PedroHiago378/humanoide-12dof/docs/artigo/fig_arquitetura.png

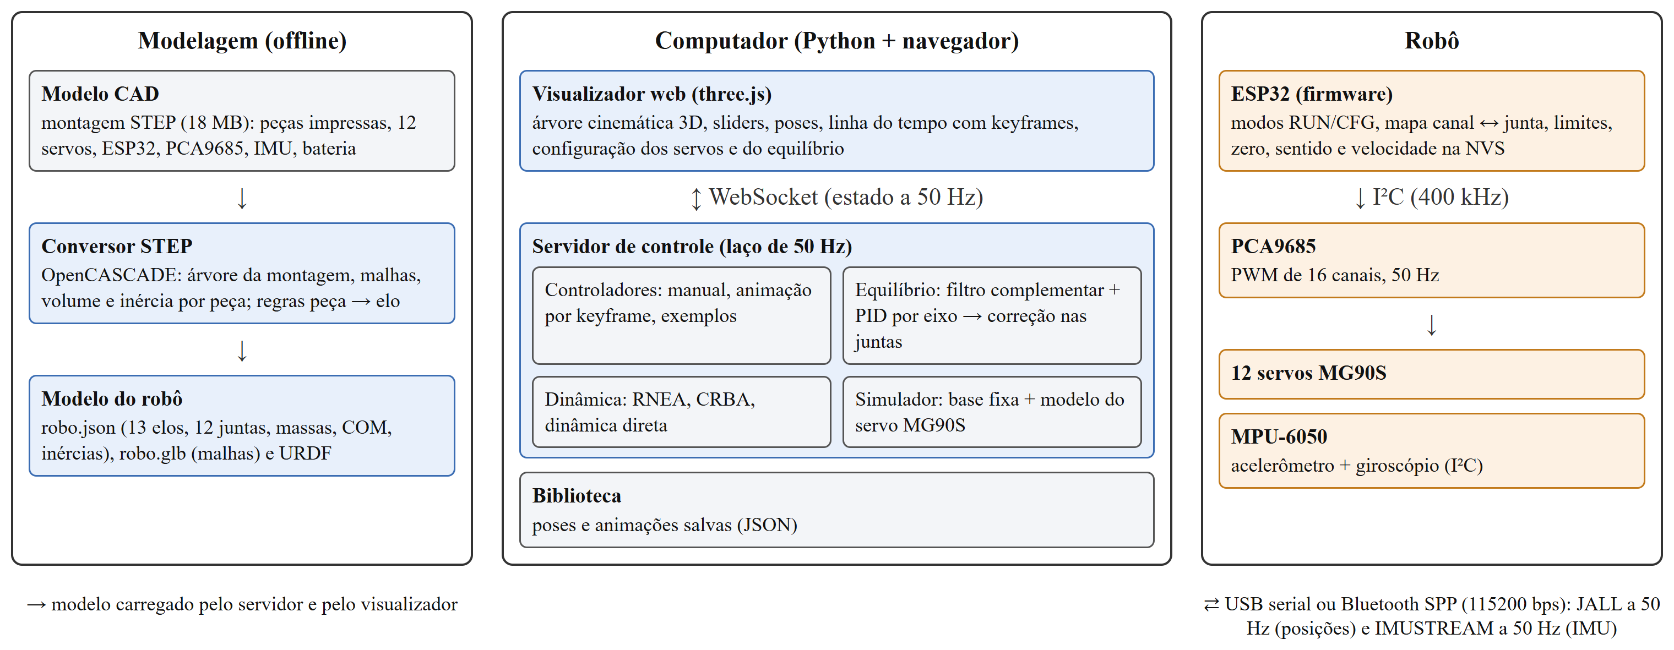
docs/artigo/fig_arquitetura.png
