PedroHiago378/humanoide-12dof/docs/artigo/fig_config_servos_crop.png

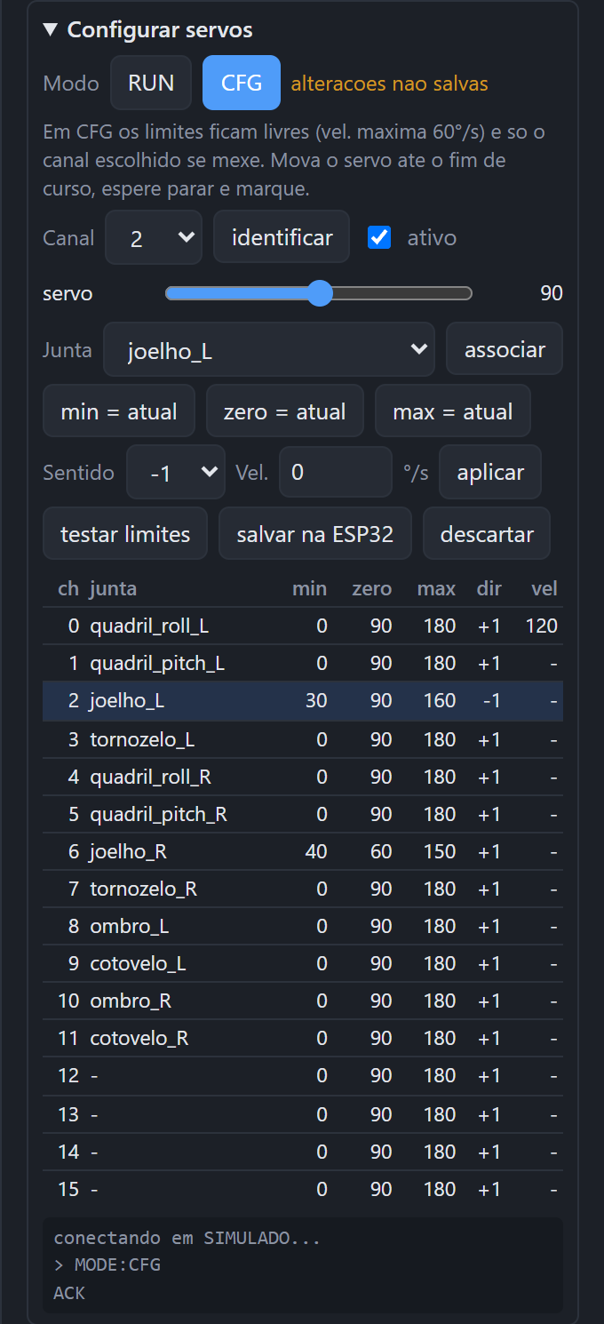
docs/artigo/fig_config_servos_crop.png
