PedroHiago378/humanoide-12dof/docs/artigo/fig_equilibrio.png

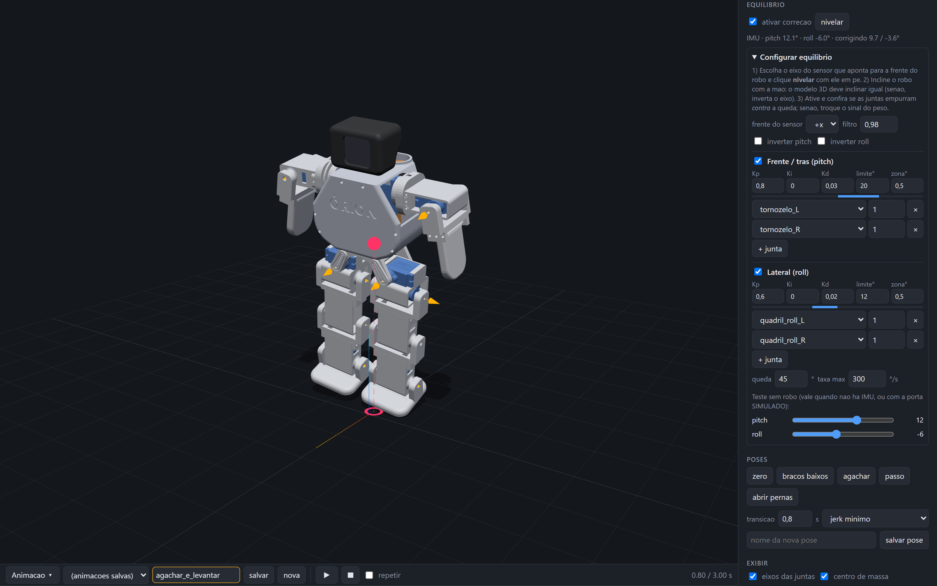
docs/artigo/fig_equilibrio.png
