PedroHiago378/humanoide-12dof/docs/artigo/fig_interpolacao.png

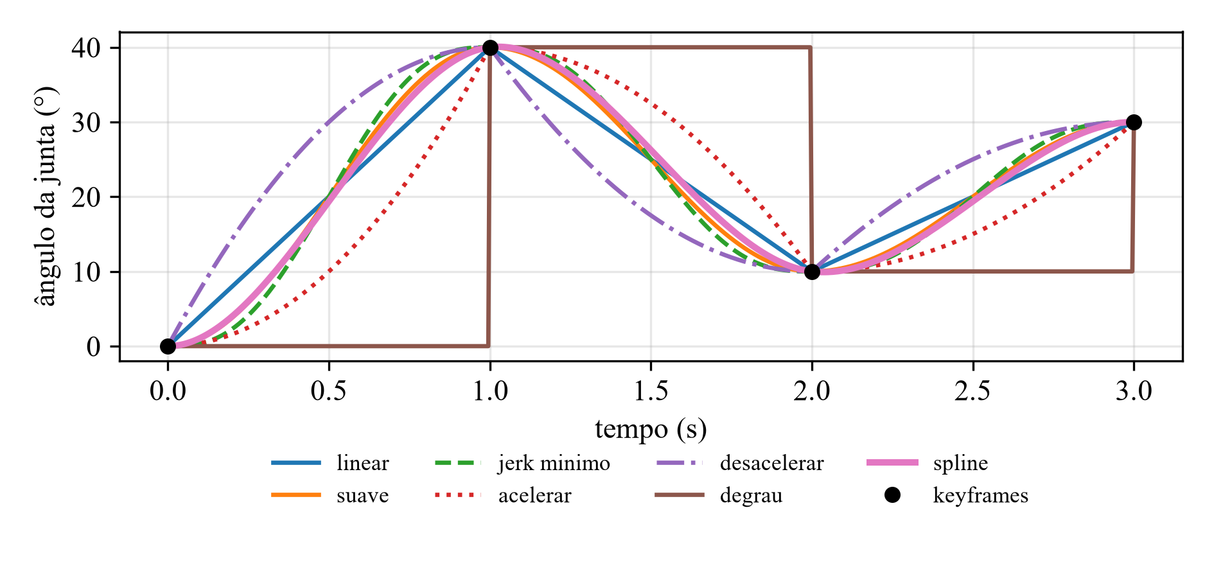
docs/artigo/fig_interpolacao.png
