PedroHiago378/humanoide-12dof/docs/artigo/fig_visao_geral.png

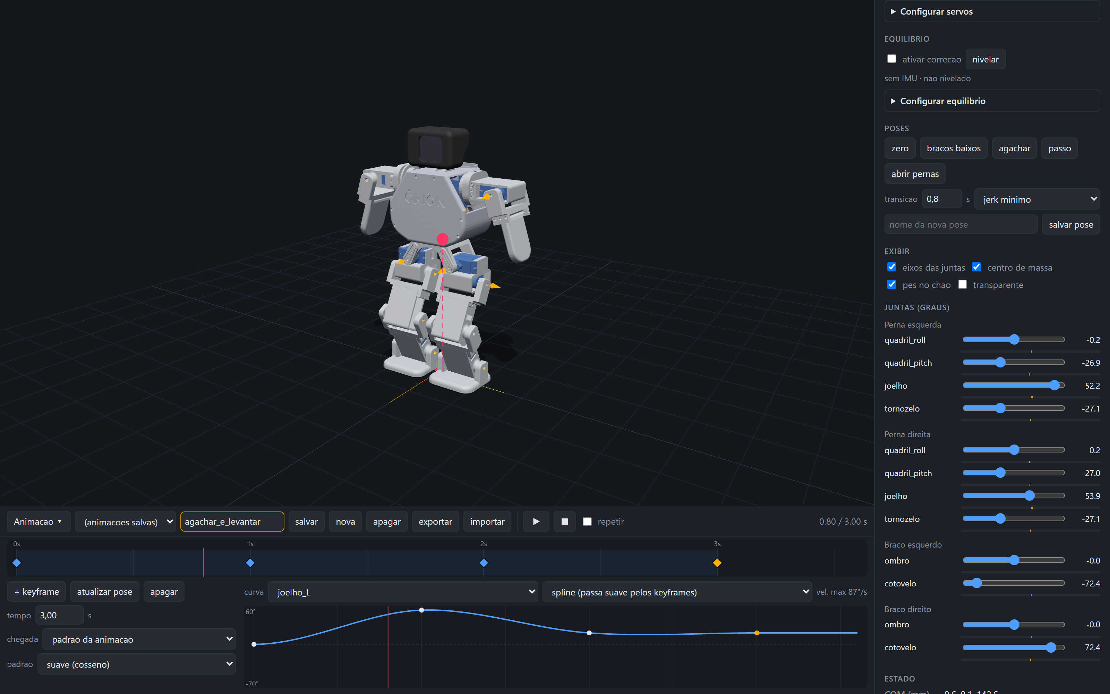
docs/artigo/fig_visao_geral.png
