PedroHiago378/humanoide-12dof/modelo/mujoco/colisao/pe_L.stl

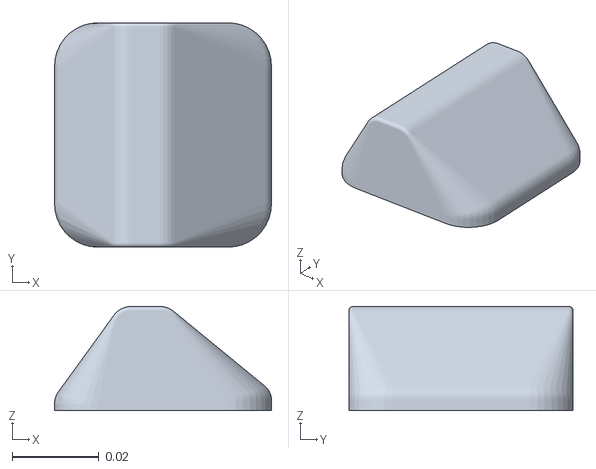
[picture p7: CAD file, 2026-11-02]
modelo/mujoco/colisao/pe_L.stl
0.05 x 0.0517 x 0.024
