PedroHiago378/humanoide-12dof/modelo/mujoco/visual/torso_0.stl

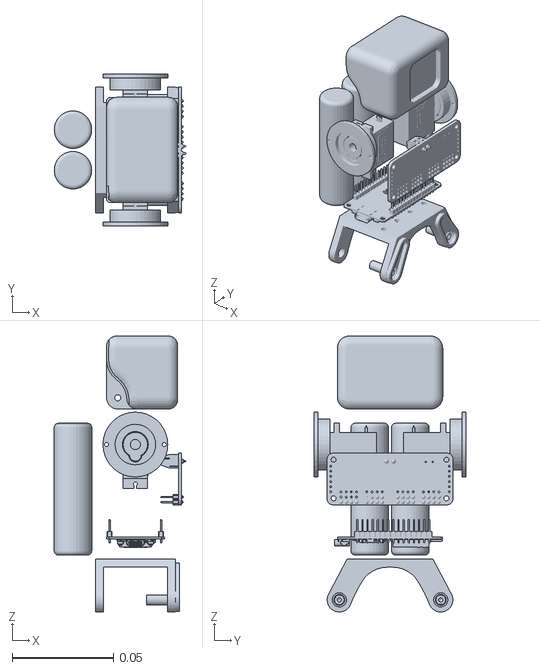
[picture p8: CAD file, 2026-11-02]
modelo/mujoco/visual/torso_0.stl
0.0649 x 0.075 x 0.136
