PedroHiago378/humanoide-12dof/modelo/mujoco/colisao/coxa_L.stl

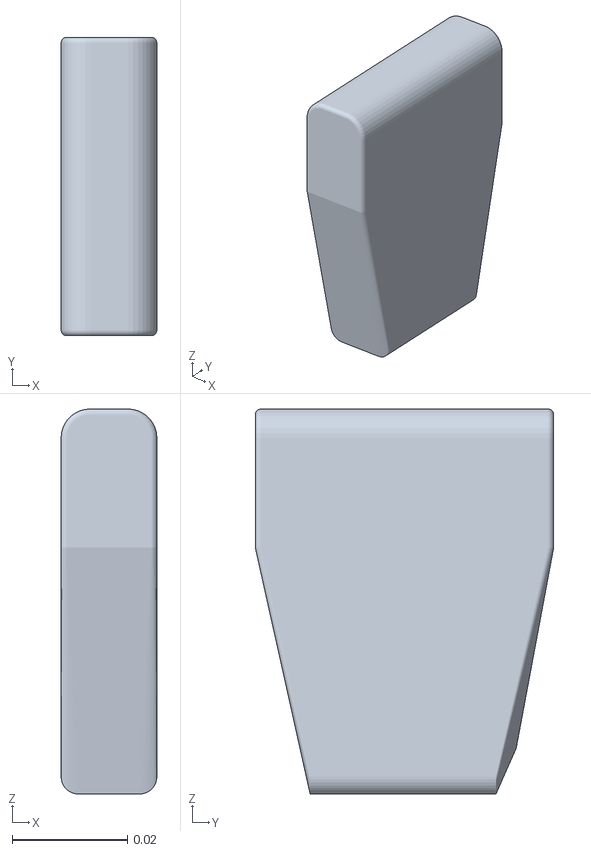
[picture p9: CAD file, 2026-11-02]
modelo/mujoco/colisao/coxa_L.stl
0.0166 x 0.0517 x 0.0667
