PedroHiago378/humanoide-12dof/modelo/mujoco/visual/coxa_R_0.stl

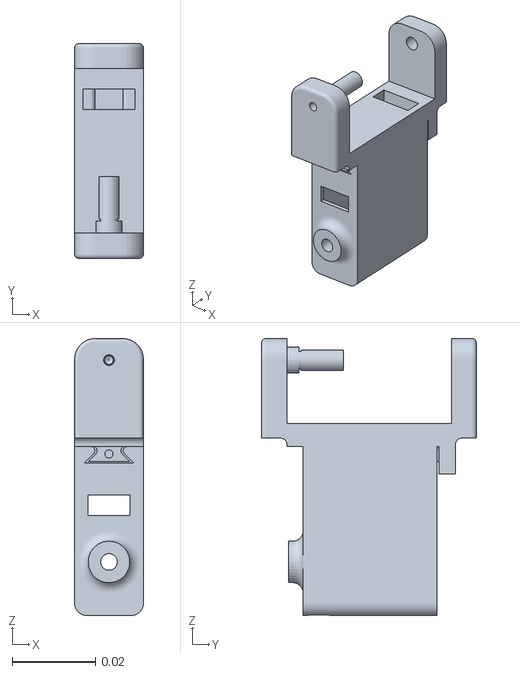
[picture p10: CAD file, 2026-11-02]
modelo/mujoco/visual/coxa_R_0.stl
0.0166 x 0.0517 x 0.0667
