PedroHiago378/humanoide-12dof/modelo/mujoco/colisao/braco_L.stl

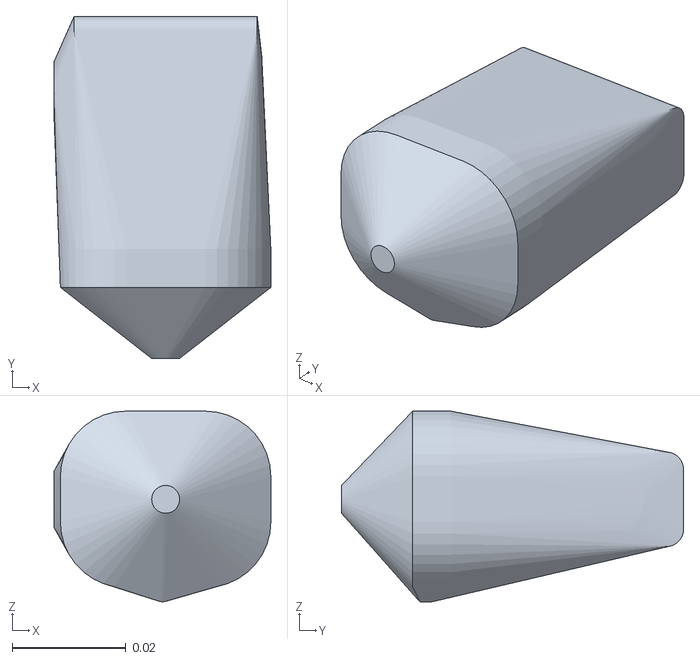
[picture p11: CAD file, 2026-11-02]
modelo/mujoco/colisao/braco_L.stl
0.0381 x 0.0601 x 0.0335
