PedroHiago378/humanoide-12dof/modelo/mujoco/colisao/antebraco_L.stl

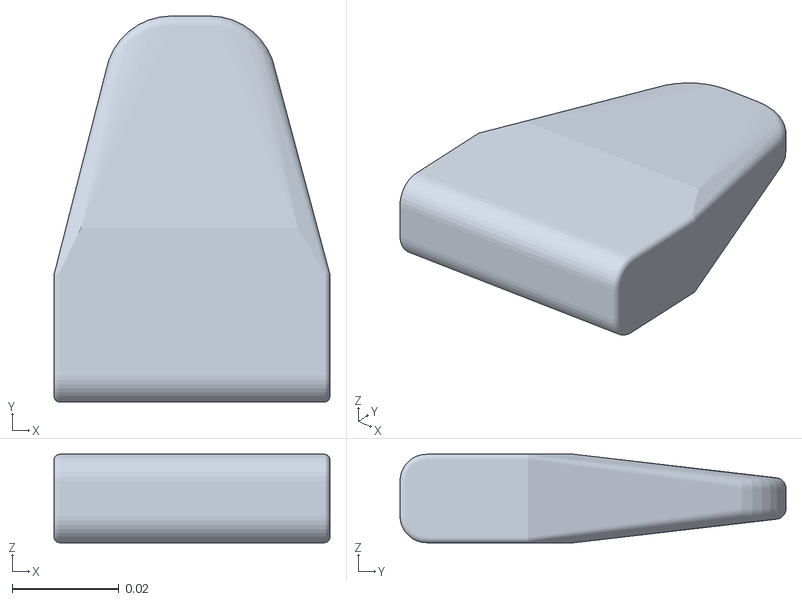
[picture p12: CAD file, 2026-11-02]
modelo/mujoco/colisao/antebraco_L.stl
0.0517 x 0.0724 x 0.0166
