PedroHiago378/humanoide-12dof/modelo/mujoco/visual/pe_R_0.stl

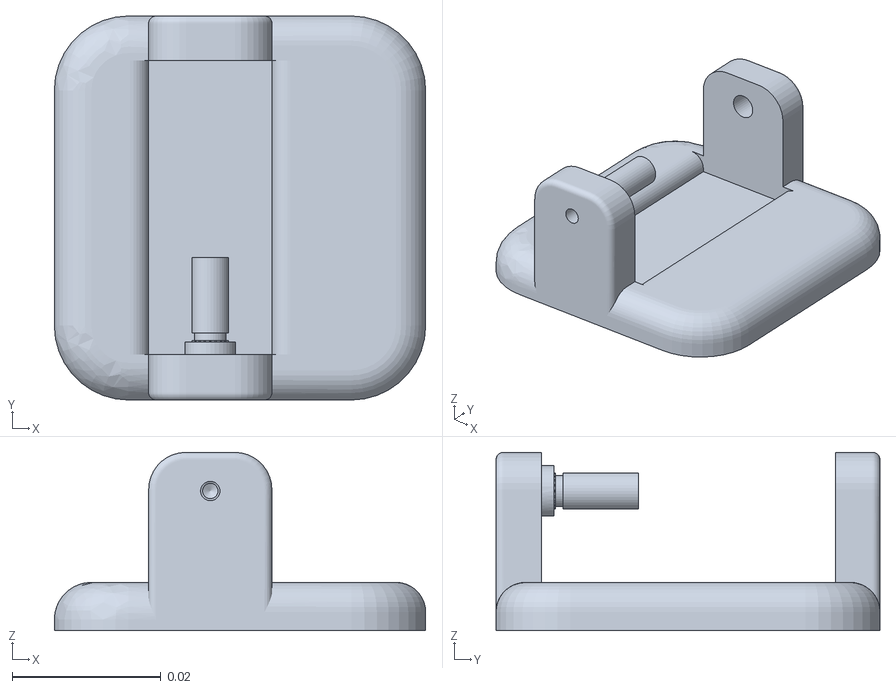
[picture p13: CAD file, 2026-11-02]
modelo/mujoco/visual/pe_R_0.stl
0.05 x 0.0517 x 0.024
