PedroHiago378/humanoide-12dof/modelo/mujoco/visual/antebraco_L_0.stl

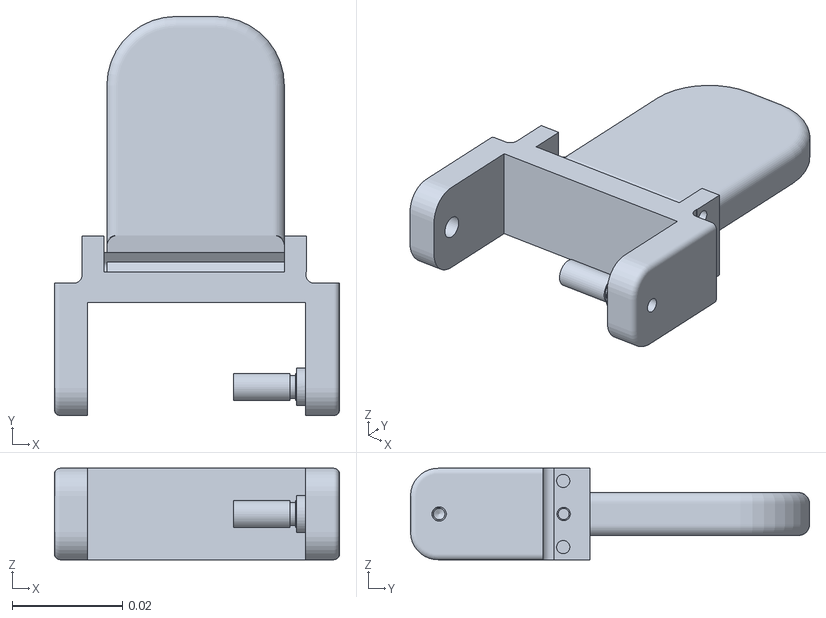
[picture p16: CAD file, 2026-11-02]
modelo/mujoco/visual/antebraco_L_0.stl
0.0517 x 0.0724 x 0.0166
