PedroHiago378/humanoide-12dof/modelo/mujoco/colisao/quadril_L.stl

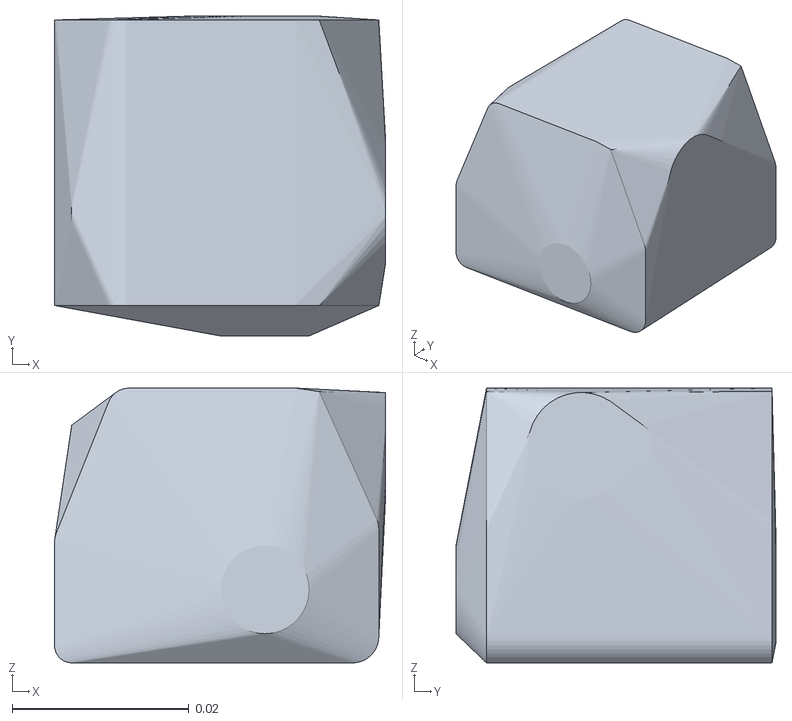
[picture p17: CAD file, 2026-11-02]
modelo/mujoco/colisao/quadril_L.stl
0.0374 x 0.0362 x 0.0311
