PedroHiago378/humanoide-12dof/modelo/mujoco/visual/torso_1.stl

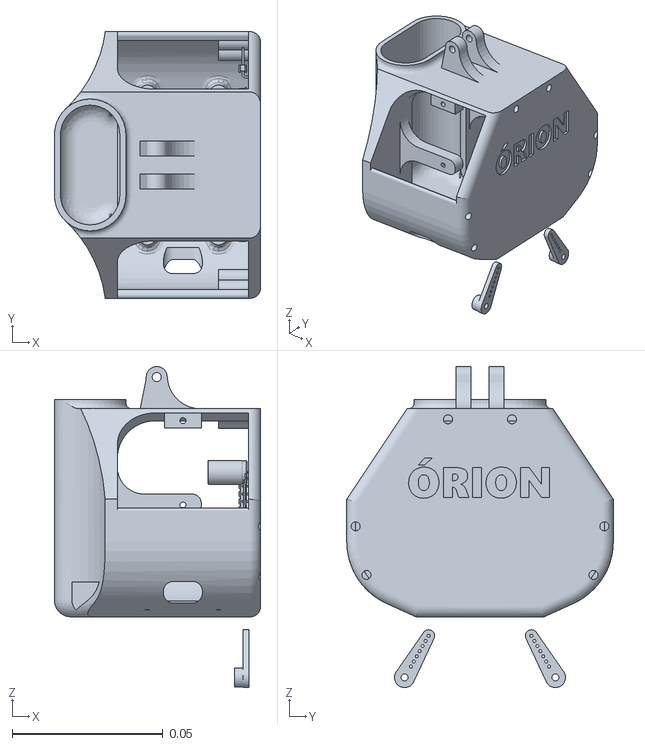
[picture p18: CAD file, 2026-11-02]
modelo/mujoco/visual/torso_1.stl
0.0683 x 0.0884 x 0.106
