PedroHiago378/humanoide-12dof/modelo/mujoco/visual/braco_R_0.stl

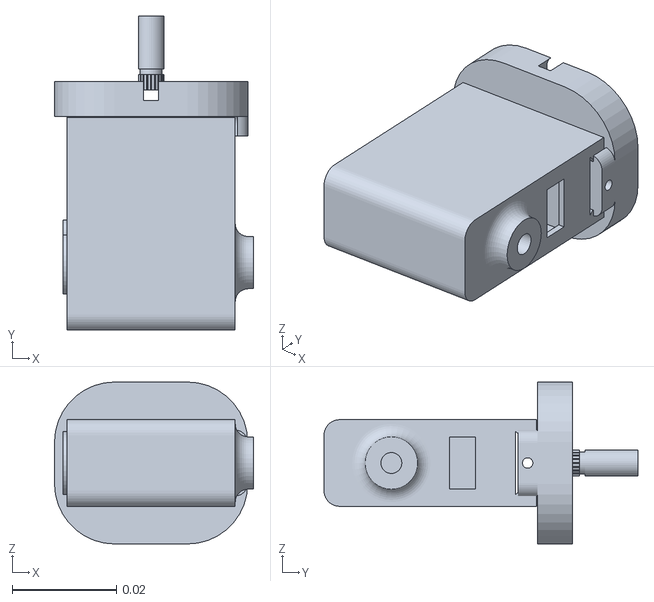
[picture p19: CAD file, 2026-11-02]
modelo/mujoco/visual/braco_R_0.stl
0.0381 x 0.0601 x 0.031
