PedroHiago378/humanoide-12dof/modelo/mujoco/colisao/torso.stl

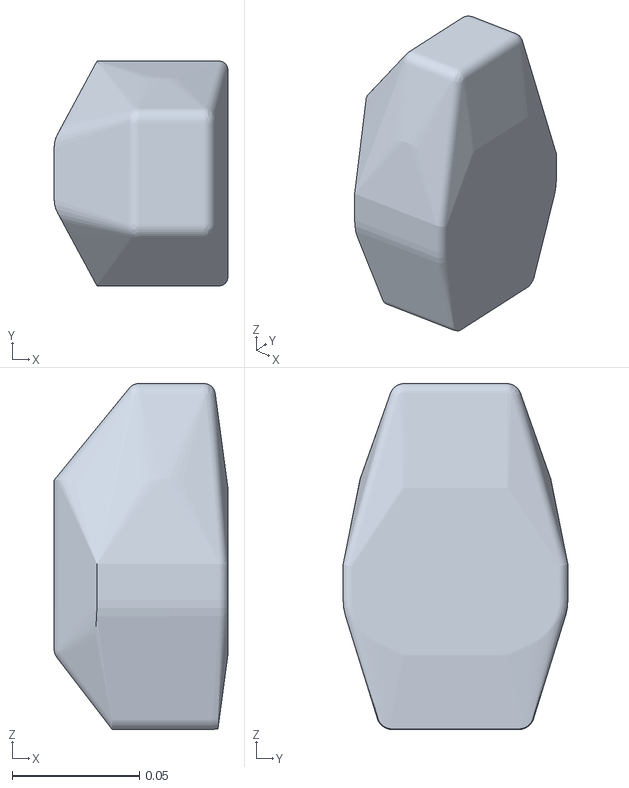
[picture p20: CAD file, 2026-11-02]
modelo/mujoco/colisao/torso.stl
0.0683 x 0.0884 x 0.136
