PedroHiago378/humanoide-12dof/modelo/mujoco/visual/quadril_L_0.stl

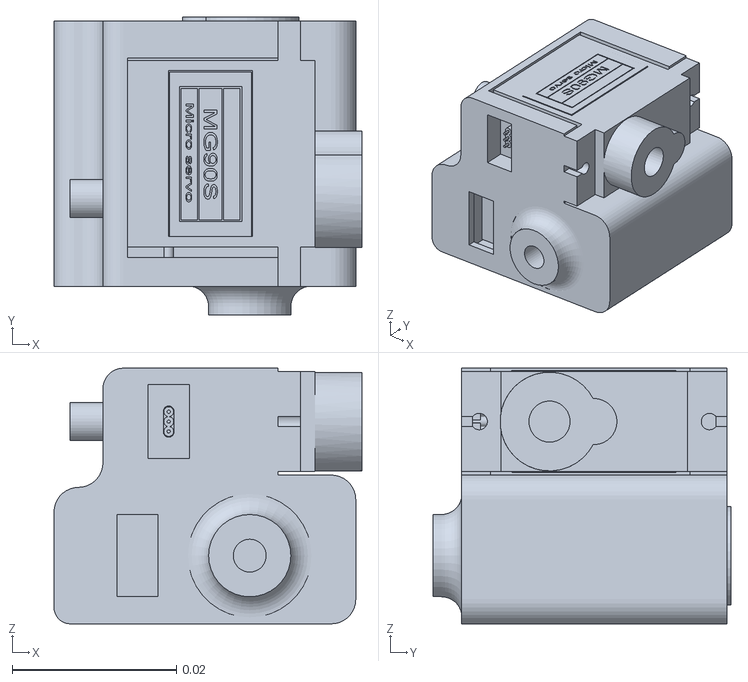
[picture p21: CAD file, 2026-11-02]
modelo/mujoco/visual/quadril_L_0.stl
0.0374 x 0.0362 x 0.0311
