PedroHiago378/humanoide-12dof/modelo/mujoco/visual/canela_L_0.stl

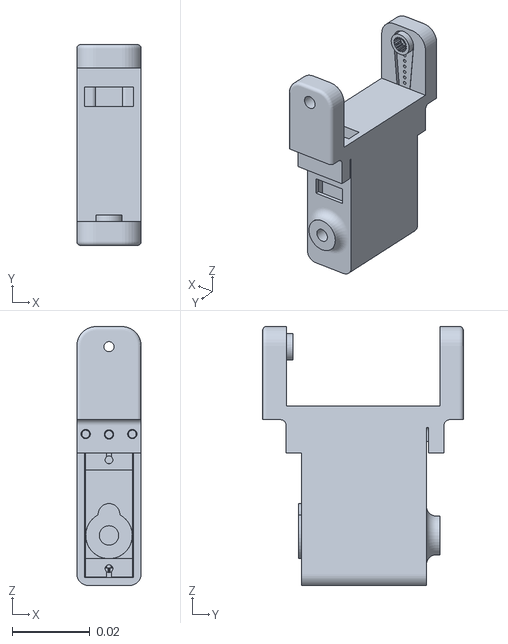
[picture p22: CAD file, 2026-10-30]
modelo/mujoco/visual/canela_L_0.stl
0.0166 x 0.0517 x 0.0667
