PedroHiago378/humanoide-12dof/(list of files, cad)

Other CAD files:
modelo/mujoco/visual/coxa_L_0.stl
modelo/mujoco/colisao/canela_R.stl
modelo/mujoco/colisao/canela_L.stl
modelo/mujoco/colisao/antebraco_R.stl
modelo/mujoco/visual/antebraco_R_0.stl
modelo/mujoco/visual/pe_L_0.stl
modelo/mujoco/colisao/pe_R.stl
modelo/mujoco/colisao/coxa_R.stl
modelo/mujoco/colisao/quadril_R.stl
modelo/mujoco/visual/quadril_R_0.stl
modelo/mujoco/visual/canela_R_0.stl
modelo/meshes/antebraco_L.stl
modelo/meshes/antebraco_R.stl
modelo/meshes/braco_L.stl
modelo/meshes/braco_R.stl
modelo/meshes/coxa_L.stl
modelo/meshes/coxa_R.stl
modelo/meshes/pe_L.stl
modelo/meshes/pe_R.stl
modelo/meshes/quadril_L.stl
modelo/meshes/torso.stl
