PedroHiago378/humanoide-12dof/modelo/robo.urdf

<?xml version="1.0"?>
<robot name="humanoide_12dof">
  <link name="torso">
    <inertial><origin xyz="-0.01809 0.00027 0.06021"/><mass value="0.23706"/>
      <inertia ixx="0.000261755" ixy="-8.658e-07" ixz="-1.9638e-05" iyy="0.000278881" iyz="-1.5759e-06" izz="0.000175768"/></inertial>
    <visual><geometry><mesh filename="meshes/torso.stl"/></geometry></visual>
    <collision><geometry><mesh filename="meshes/torso.stl"/></geometry></collision>
  </link>
  <link name="antebraco_L">
    <inertial><origin xyz="-0.00668 0.02866 -3e-05"/><mass value="0.01676"/>
      <inertia ixx="5.9565e-06" ixy="1.676e-07" ixz="-0" iyy="3.5088e-06" iyz="0" izz="9.0447e-06"/></inertial>
    <visual><geometry><mesh filename="meshes/antebraco_L.stl"/></geometry></visual>
    <collision><geometry><mesh filename="meshes/antebraco_L.stl"/></geometry></collision>
  </link>
  <link name="antebraco_R">
    <inertial><origin xyz="0.00581 -0.02869 -3e-05"/><mass value="0.01676"/>
      <inertia ixx="5.9565e-06" ixy="-4.82e-08" ixz="0" iyy="3.5133e-06" iyz="0" izz="9.0492e-06"/></inertial>
    <visual><geometry><mesh filename="meshes/antebraco_R.stl"/></geometry></visual>
    <collision><geometry><mesh filename="meshes/antebraco_R.stl"/></geometry></collision>
  </link>
  <link name="braco_L">
    <inertial><origin xyz="-5e-05 0.03495 -5e-05"/><mass value="0.02715"/>
      <inertia ixx="6.0057e-06" ixy="-1.157e-07" ixz="-3e-10" iyy="2.8934e-06" iyz="-1.22e-08" izz="7.2874e-06"/></inertial>
    <visual><geometry><mesh filename="meshes/braco_L.stl"/></geometry></visual>
    <collision><geometry><mesh filename="meshes/braco_L.stl"/></geometry></collision>
  </link>
  <link name="braco_R">
    <inertial><origin xyz="-6e-05 -0.03516 -3e-05"/><mass value="0.0269"/>
      <inertia ixx="5.8859e-06" ixy="-1.129e-07" ixz="-0" iyy="2.8766e-06" iyz="-0" izz="7.1831e-06"/></inertial>
    <visual><geometry><mesh filename="meshes/braco_R.stl"/></geometry></visual>
    <collision><geometry><mesh filename="meshes/braco_R.stl"/></geometry></collision>
  </link>
  <link name="canela_L">
    <inertial><origin xyz="-5e-05 0.02293 -0.03475"/><mass value="0.02815"/>
      <inertia ixx="1.09227e-05" ixy="-0" ixz="-0" iyy="7.5734e-06" iyz="-3.05e-08" izz="4.5379e-06"/></inertial>
    <visual><geometry><mesh filename="meshes/canela_L.stl"/></geometry></visual>
    <collision><geometry><mesh filename="meshes/canela_L.stl"/></geometry></collision>
  </link>
  <link name="canela_R">
    <inertial><origin xyz="5e-05 -0.0234 -0.03475"/><mass value="0.02815"/>
      <inertia ixx="1.09276e-05" ixy="-0" ixz="-0" iyy="7.5734e-06" iyz="-2.435e-07" izz="4.5428e-06"/></inertial>
    <visual><geometry><mesh filename="meshes/canela_R.stl"/></geometry></visual>
    <collision><geometry><mesh filename="meshes/canela_R.stl"/></geometry></collision>
  </link>
  <link name="coxa_L">
    <inertial><origin xyz="-5e-05 -0.00563 -0.02604"/><mass value="0.01469"/>
      <inertia ixx="7.6347e-06" ixy="0" ixz="0" iyy="4.986e-06" iyz="-5.6e-09" izz="3.49e-06"/></inertial>
    <visual><geometry><mesh filename="meshes/coxa_L.stl"/></geometry></visual>
    <collision><geometry><mesh filename="meshes/coxa_L.stl"/></geometry></collision>
  </link>
  <link name="coxa_R">
    <inertial><origin xyz="-5e-05 0.00563 -0.02604"/><mass value="0.01469"/>
      <inertia ixx="7.6347e-06" ixy="-0" ixz="0" iyy="4.986e-06" iyz="5.6e-09" izz="3.49e-06"/></inertial>
    <visual><geometry><mesh filename="meshes/coxa_R.stl"/></geometry></visual>
    <collision><geometry><mesh filename="meshes/coxa_R.stl"/></geometry></collision>
  </link>
  <link name="pe_L">
    <inertial><origin xyz="0.00381 0.00631 -0.01322"/><mass value="0.01376"/>
      <inertia ixx="4.224e-06" ixy="-1.75e-08" ixz="1.221e-07" iyy="2.847e-06" iyz="7.91e-08" izz="6.1305e-06"/></inertial>
    <visual><geometry><mesh filename="meshes/pe_L.stl"/></geometry></visual>
    <collision><geometry><mesh filename="meshes/pe_L.stl"/></geometry></collision>
  </link>
  <link name="pe_R">
    <inertial><origin xyz="0.00381 0.00631 -0.01322"/><mass value="0.01376"/>
      <inertia ixx="4.224e-06" ixy="-1.75e-08" ixz="1.221e-07" iyy="2.847e-06" iyz="7.91e-08" izz="6.1305e-06"/></inertial>
    <visual><geometry><mesh filename="meshes/pe_R.stl"/></geometry></visual>
    <collision><geometry><mesh filename="meshes/pe_R.stl"/></geometry></collision>
  </link>
  <link name="quadril_L">
    <inertial><origin xyz="-0.00792 0.00534 -0.00915"/><mass value="0.03647"/>
      <inertia ixx="5.3739e-06" ixy="5.6e-09" ixz="-3.346e-07" iyy="5.7445e-06" iyz="5e-10" izz="5.3355e-06"/></inertial>
    <visual><geometry><mesh filename="meshes/quadril_L.stl"/></geometry></visual>
    <collision><geometry><mesh filename="meshes/quadril_L.stl"/></geometry></collision>
  </link>
  <link name="quadril_R">
    <inertial><origin xyz="-0.00792 -0.00534 -0.00915"/><mass value="0.03647"/>
      <inertia ixx="5.3739e-06" ixy="-5.6e-09" ixz="-3.346e-07" iyy="5.7445e-06" iyz="-5e-10" izz="5.3355e-06"/></inertial>
    <visual><geometry><mesh filename="meshes/quadril_R.stl"/></geometry></visual>
    <collision><geometry><mesh filename="meshes/quadril_R.stl"/></geometry></collision>
  </link>
  <joint name="quadril_roll_L" type="revolute">
    <parent link="torso"/><child link="quadril_L"/>
    <origin xyz="0 0.025 0"/><axis xyz="1 0 0"/>
    <limit lower="-1.5708" upper="1.5708" effort="0.21" velocity="10.5"/>
  </joint>
  <joint name="quadril_pitch_L" type="revolute">
    <parent link="quadril_L"/><child link="coxa_L"/>
    <origin xyz="-0.0034 0.0118 -0.0163"/><axis xyz="0 1 0"/>
    <limit lower="-1.5708" upper="1.5708" effort="0.21" velocity="10.5"/>
  </joint>
  <joint name="joelho_L" type="revolute">
    <parent link="coxa_L"/><child link="canela_L"/>
    <origin xyz="0 -0.0293 -0.0486"/><axis xyz="0 1 0"/>
    <limit lower="-1.5708" upper="1.5708" effort="0.21" velocity="10.5"/>
  </joint>
  <joint name="tornozelo_L" type="revolute">
    <parent link="canela_L"/><child link="pe_L"/>
    <origin xyz="-0.0001 0.0164 -0.0486"/><axis xyz="0 1 0"/>
    <limit lower="-1.5708" upper="1.5708" effort="0.21" velocity="10.5"/>
  </joint>
  <joint name="quadril_roll_R" type="revolute">
    <parent link="torso"/><child link="quadril_R"/>
    <origin xyz="0 -0.025 0"/><axis xyz="1 0 0"/>
    <limit lower="-1.5708" upper="1.5708" effort="0.21" velocity="10.5"/>
  </joint>
  <joint name="quadril_pitch_R" type="revolute">
    <parent link="quadril_R"/><child link="coxa_R"/>
    <origin xyz="-0.0034 -0.0118 -0.0163"/><axis xyz="0 1 0"/>
    <limit lower="-1.5708" upper="1.5708" effort="0.21" velocity="10.5"/>
  </joint>
  <joint name="joelho_R" type="revolute">
    <parent link="coxa_R"/><child link="canela_R"/>
    <origin xyz="-0.0001 0.0293 -0.0486"/><axis xyz="0 1 0"/>
    <limit lower="-1.5708" upper="1.5708" effort="0.21" velocity="10.5"/>
  </joint>
  <joint name="tornozelo_R" type="revolute">
    <parent link="canela_R"/><child link="pe_R"/>
    <origin xyz="0 -0.0303 -0.0486"/><axis xyz="0 1 0"/>
    <limit lower="-1.5708" upper="1.5708" effort="0.21" velocity="10.5"/>
  </joint>
  <joint name="ombro_L" type="revolute">
    <parent link="torso"/><child link="braco_L"/>
    <origin xyz="-0.0055 0.025 0.0766"/><axis xyz="0 1 0"/>
    <limit lower="-1.5708" upper="1.5708" effort="0.21" velocity="10.5"/>
  </joint>
  <joint name="cotovelo_L" type="revolute">
    <parent link="braco_L"/><child link="antebraco_L"/>
    <origin xyz="0.0067 0.0472 0"/><axis xyz="1 0 0"/>
    <limit lower="-1.5708" upper="1.5708" effort="0.21" velocity="10.5"/>
  </joint>
  <joint name="ombro_R" type="revolute">
    <parent link="torso"/><child link="braco_R"/>
    <origin xyz="-0.0055 -0.025 0.0766"/><axis xyz="0 1 0"/>
    <limit lower="-1.5708" upper="1.5708" effort="0.21" velocity="10.5"/>
  </joint>
  <joint name="cotovelo_R" type="revolute">
    <parent link="braco_R"/><child link="antebraco_R"/>
    <origin xyz="-0.0068 -0.0472 0"/><axis xyz="1 0 0"/>
    <limit lower="-1.5708" upper="1.5708" effort="0.21" velocity="10.5"/>
  </joint>
</robot>
