PedroHiago378/humanoide-12dof/controle/servidor.py

"""Servidor de controle: roda controlador + simulador e transmite o estado ao visualizador.

    python -m controle.servidor                   # so simulacao; conecte a ESP32 pela pagina
    python -m controle.servidor --serial COM5     # ja conecta na ESP32 (USB ou COM do Bluetooth)
    python -m controle.servidor --serial SIMULADO # emulador do firmware, sem placa

Abra http://127.0.0.1:8790 no navegador.
"""
import argparse
import asyncio
import json
import logging
import os
import time

import numpy as np
from aiohttp import WSMsgType, web

from . import biblioteca, hardware
from .controladores import CONTROLADORES
from .equilibrio import Equilibrio
from .modelo import RAIZ, Robo
from .simulador import SimuladorBaseFixa

TAXA_UI = 50  # Hz de envio ao visualizador e ao hardware


class Nucleo:
    def __init__(self, robo):
        self.robo = robo
        self.limite_modelo = robo.limite.copy()
        self.sim = SimuladorBaseFixa(robo)
        self.hw = None             # ESP32Humanoide conectada
        self.hw_seguir = False     # envia o comando de posicao aos servos
        self._q_hw, self._t_hw = None, 0.0   # ultimo quadro enviado aos servos
        self.controladores = {c.nome: c(robo) for c in CONTROLADORES}
        self.equilibrio = Equilibrio(robo)
        self.sim_mj = None         # SimMuJoCo (aba Simulacao e treino), criado ao ligar
        self.sim_mj_ativo = False
        self.sim_mj_poses = False  # True: poses/animacoes/sliders movem o robo livre em vez da politica
        self._reinicios_poses = None
        self.trava_rl = asyncio.Lock()
        try:
            from .rl_servico import ServicoTreino
            self.treino = ServicoTreino()
        except Exception as e:     # sem mujoco/gymnasium: aba de simulacao indisponivel
            self.treino, self.erro_rl = None, str(e)
        self._coleta_imu = None    # lista de amostras durante o "nivelar"
        self.clientes = set()
        self.trocar("manual")

    def trocar(self, nome):
        self.ctrl = self.controladores[nome]
        self.ctrl.reiniciar(self.sim.estado)

    def info(self):
        return {"tipo": "info", "controladores": list(self.controladores), "controlador": self.ctrl.nome,
                "limites": {n: np.degrees(l).round(1).tolist() for n, l in zip(self.robo.nomes, self.robo.limite)}}

    async def difundir(self, msg):
        texto = json.dumps(msg)
        for ws in list(self.clientes):
            try:
                await ws.send_str(texto)
            except ConnectionError:
                self.clientes.discard(ws)

    # ---------------------------------------------------------------- ESP32
    def aplicar_limites(self, config):
        """Limites gravados na ESP32 passam a valer no simulador e nos sliders."""
        self.robo.limite[:] = self.limite_modelo
        for nome, (lo, hi) in hardware.limites_das_juntas(config or {}).items():
            self.robo.limite[self.robo.indice[nome]] = np.radians([lo, hi])

    async def hw_conectar(self, porta):
        await self.hw_desconectar()
        self.hw = await asyncio.to_thread(hardware.ESP32Humanoide, porta)
        ok, linhas = await asyncio.to_thread(self.hw.comando, "JOINTS")
        juntas = next((l.split(",") for l in linhas if "," in l), [])
        if not ok or [j.lower() for j in juntas] != [n.lower() for n in self.robo.nomes]:
            await self.hw_desconectar()
            raise RuntimeError(f"firmware nao respondeu JOINTS com as 12 juntas do modelo: {linhas}")
        await self.hw_recarregar()
        ok, linhas = await asyncio.to_thread(self.hw.comando, "IMUSTREAM:20")   # IMU a 50 Hz
        if not ok:
            await self.difundir({"tipo": "aviso", "texto": "Firmware sem IMUSTREAM: grave a versao 2.2 para o equilibrio."})

    async def hw_desconectar(self):
        if self.hw:
            hw, self.hw = self.hw, None
            await asyncio.to_thread(hw.fechar)
        self.hw_seguir = False
        self.aplicar_limites(None)
        await self.difundir(self.info())

    async def hw_recarregar(self):
        config = await asyncio.to_thread(self.hw.ler_config)
        self.aplicar_limites(config)
        await self.difundir({"tipo": "hw_config", "config": config})
        await self.difundir(self.info())

    def hw_estado(self):
        if not self.hw:
            return None
        return {"porta": self.hw.porta, "modo": self.hw.modo, "seguir": self.hw_seguir, "status": self.hw.status,
                "log": self.hw.log[-8:]}

    async def laco_status(self):
        """Telemetria por consulta: o heartbeat da ESP32 so sai pela USB, nao pelo Bluetooth.
        Tambem manda o progresso do treino de RL."""
        while True:
            await asyncio.sleep(1.0)
            if self.treino and self.clientes:
                try:
                    st = await asyncio.to_thread(self.treino.estado)
                    await self.difundir({"tipo": "rl_estado", **st})
                    # lista de execucoes: quando um treino comeca/termina e a cada 15 s
                    self._tick_rl = getattr(self, "_tick_rl", 0) + 1
                    if st["rodando"] != getattr(self, "_rodava", None) or self._tick_rl % 15 == 0:
                        self._rodava = st["rodando"]
                        await self.difundir({"tipo": "rl_lista", "execucoes": await asyncio.to_thread(self.treino.listar)})
                except Exception:
                    pass
            hw = self.hw
            if hw:
                try:
                    await asyncio.to_thread(hw.atualizar_status)
                except Exception:  # porta caiu; o erro aparece no log da placa
                    pass

    # ---------------------------------------------------------------- laco
    def avancar(self, duracao, correcao=0.0):
        """Integra o simulador por `duracao` segundos; retorna o ultimo comando de posicao.
        `correcao` (rad) e somada ao comando de posicao (equilibrio)."""
        q_ref = None
        for _ in range(max(1, round(duracao / self.sim.dt))):
            e = self.sim.estado
            u = self.ctrl.calcular(e.t, e)
            if self.ctrl.tipo == "torque":
                self.sim.passo(tau=u)
            else:
                q_ref = self.robo.limitar(u + correcao)
                self.sim.passo(q_ref=q_ref)
        return q_ref

    async def laco(self):
        periodo = 1 / TAXA_UI
        proximo = time.perf_counter()
        while True:
            hw = self.hw
            for t_ms, acel, giro in (hw.amostras_imu() if hw else []):
                self.equilibrio.amostra(t_ms, acel, giro)
                if self._coleta_imu is not None:
                    self._coleta_imu.append((t_ms, acel, giro))
            if self.sim_mj_ativo:
                # simulacao MuJoCo: o robo livre (politica de RL ou poses) substitui os servos
                try:
                    q_alvo = None
                    if self.sim_mj_poses:   # o controlador da aba Controle da os alvos; o MuJoCo, a fisica
                        if self.sim_mj.reinicios != self._reinicios_poses:
                            _poses_da_sim(self)   # reiniciou ou recriou: parte da pose nova, sem pulo
                            await self.difundir(self.info())
                        q_ref = self.avancar(periodo)
                        q_alvo = (self.sim.estado.q if q_ref is None else q_ref)[self._idx_mj]
                    self.sim_mj.passo(q_alvo)
                    mj = self.sim_mj.estado()
                except Exception as e:   # erro na simulacao nao pode parar o laco
                    logging.getLogger("humanoide").exception("simulacao MuJoCo")
                    self.sim_mj_ativo = False
                    await self.difundir({"tipo": "aviso", "texto": f"simulacao MuJoCo: {e}"})
                    continue
                poses = self.sim_mj_poses
                await self.difundir({"tipo": "estado", "t": mj["info"]["t"],
                                     "controlador": self.ctrl.nome if poses else "MuJoCo",
                                     "fonte": "MuJoCo" + (" (poses)" if poses else ""), "q": mj["q"],
                                     "base": mj["base"], "mujoco": mj["info"], "hw": self.hw_estado(), "eq": None,
                                     "anim": self.ctrl.estado_ui() if poses and hasattr(self.ctrl, "estado_ui") else None})
                proximo += periodo
                await asyncio.sleep(max(0.0, proximo - time.perf_counter()))
                if time.perf_counter() - proximo > 0.5:
                    proximo = time.perf_counter()
                continue
            q_ref = self.avancar(periodo, self.equilibrio.correcao(periodo))
            if hw and self.hw_seguir and hw.modo == "run":
                # servo de hobby so aceita posicao: controlador de torque manda o estado simulado
                q_hw = self.sim.estado.q if q_ref is None else q_ref
                agora = time.perf_counter()
                # manda quando muda (> 0.05 grau) e, parado, reenvia a cada 0.5 s
                if (self._q_hw is None or np.abs(q_hw - self._q_hw).max() > np.radians(0.05)
                        or agora - self._t_hw > 0.5):
                    await asyncio.to_thread(hw.enviar, q_hw, 1000 / TAXA_UI)
                    self._q_hw, self._t_hw = q_hw.copy(), agora
            else:
                self._q_hw = None
            e = self.sim.estado
            await self.difundir({
                "tipo": "estado", "t": e.t, "controlador": self.ctrl.nome,
                "fonte": "simulacao" + (" + servos" if hw and self.hw_seguir else ""),
                "q": self.robo.dict_de(e.q), "tau": self.robo.dict_de(e.tau, graus=False),
                "hw": self.hw_estado(),
                "anim": self.ctrl.estado_ui() if hasattr(self.ctrl, "estado_ui") else None,
                "eq": self.equilibrio.estado_ui(),
            })
            proximo += periodo
            await asyncio.sleep(max(0.0, proximo - time.perf_counter()))
            if time.perf_counter() - proximo > 0.5:  # atrasou demais: ressincroniza
                proximo = time.perf_counter()


# comandos que nao mudam a configuracao (nao precisam reler o CFG)
SO_MOVIMENTO = ("POS", "WIGGLE", "CENTER", "REST", "STATUS", "PING", "INFO", "IMU", "SCAN", "J:", "JALL")


async def tratar_hw(nucleo, ws, msg):
    tipo = msg["tipo"]
    try:
        if tipo == "hw_portas":
            desc = await asyncio.to_thread(hardware.descrever_portas)
            portas = [{"porta": p, "desc": desc.get(p, "emulador do firmware" if p == hardware.PORTA_SIMULADA else "")}
                      for p in await asyncio.to_thread(hardware.listar_portas)]
            await ws.send_json({"tipo": "hw_portas", "portas": portas})
        elif tipo == "hw_conectar":
            await nucleo.hw_conectar(msg["porta"])
        elif tipo == "hw_desconectar":
            await nucleo.hw_desconectar()
        elif tipo == "hw_seguir":
            if msg["ligado"] and nucleo.hw and not nucleo.hw_seguir:
                # leva os servos devagar ate a pose atual antes de comecar o fluxo de 50 Hz
                await asyncio.to_thread(nucleo.hw.enviar, nucleo.sim.estado.q, 1500)
                await asyncio.sleep(1.6)
            nucleo.hw_seguir = bool(msg["ligado"]) and nucleo.hw is not None
        elif tipo == "hw_cmd":
            if not nucleo.hw:
                raise RuntimeError("ESP32 nao conectada")
            cmd = msg["cmd"].strip()
            ok, linhas = await asyncio.to_thread(nucleo.hw.comando, cmd)
            await ws.send_json({"tipo": "hw_resp", "id": msg.get("id"), "cmd": cmd, "ok": ok, "linhas": linhas})
            if ok and not cmd.upper().startswith(SO_MOVIMENTO):
                await nucleo.hw_recarregar()
    except Exception as e:  # erro de porta/firmware vai para a pagina
        await ws.send_json({"tipo": "hw_resp", "id": msg.get("id"), "cmd": msg.get("cmd", tipo), "ok": False,
                            "linhas": [f"ERRO: {e}"]})


async def tratar_equilibrio(nucleo, ws, msg):
    eq, tipo = nucleo.equilibrio, msg["tipo"]
    try:
        if tipo == "eq_config":
            eq.configurar(msg["config"])
        elif tipo == "eq_ativar":
            eq.configurar({"ativo": bool(msg["ligado"])})
        elif tipo == "eq_simular":
            eq.simulado = None if msg.get("pitch") is None else (float(msg["pitch"]), float(msg["roll"]))
            if nucleo.hw and nucleo.hw.porta == hardware.PORTA_SIMULADA:   # emulador: inclina a IMU de mentira
                nucleo.hw.ser.inclinacao = eq.simulado or (0.0, 0.0)
            return
        elif tipo == "eq_nivelar":
            if not nucleo.hw:
                raise RuntimeError("conecte a ESP32 primeiro")
            nucleo._coleta_imu = []
            await asyncio.sleep(1.0)
            amostras, nucleo._coleta_imu = nucleo._coleta_imu, None
            eq.nivelar(amostras)
            await ws.send_json({"tipo": "aviso", "texto": f"Nivelado com {len(amostras)} amostras."})
        await nucleo.difundir({"tipo": "eq_config", "config": eq.cfg})
    except Exception as e:
        nucleo._coleta_imu = None
        await ws.send_json({"tipo": "aviso", "texto": f"equilibrio: {e}"})


async def tratar_rl(nucleo, ws, msg):
    """Aba Simulacao e treino: sim_* (MuJoCo no programa) e rl_* (treino em processo externo).
    Uma mensagem por vez, na ordem em que chegaram (ligar, configurar e carregar dependem uma da outra)."""
    async with nucleo.trava_rl:
        await _tratar_rl(nucleo, ws, msg)


async def _criar_sim(nucleo):
    if nucleo.sim_mj is None:
        from .sim_mujoco import JUNTAS, SimMuJoCo
        nucleo._idx_mj = [nucleo.robo.nomes.index(n) for n in JUNTAS]   # ordem do programa -> ordem do MuJoCo
        nucleo.sim_mj = await asyncio.to_thread(SimMuJoCo)


def _poses_da_sim(nucleo):
    """O controle manual parte da pose atual do robo livre (sem pulo ao trocar politica -> poses)."""
    e = nucleo.sim_mj.env
    q = nucleo.sim.estado.q.copy()
    q[nucleo._idx_mj] = e.data.qpos[e.qadr]
    nucleo.sim.reiniciar(q)
    nucleo.trocar("manual")
    nucleo._reinicios_poses = nucleo.sim_mj.reinicios


async def _tratar_rl(nucleo, ws, msg):
    tipo = msg["tipo"]
    treino = nucleo.treino
    try:
        if treino is None:
            raise RuntimeError(f"simulacao indisponivel: {getattr(nucleo, 'erro_rl', '')}")
        if tipo == "sim_ligar":
            if msg["ligado"]:
                await _criar_sim(nucleo)
                nucleo.hw_seguir = False    # o robo real nao segue a simulacao
            nucleo.sim_mj_ativo = bool(msg["ligado"])
        elif tipo == "sim_modo":
            poses = msg.get("modo") == "poses"
            if nucleo.sim_mj:
                nucleo.sim_mj.poses = poses
            if poses and nucleo.sim_mj:
                _poses_da_sim(nucleo)
                await nucleo.difundir(nucleo.info())
            nucleo.sim_mj_poses = poses
        elif tipo == "sim_politica":
            caminho = treino.politica(msg["nome"]) if msg.get("nome") else None
            if caminho and not os.path.exists(caminho):
                caminho = await asyncio.to_thread(treino.exportar, msg["nome"])
            await _criar_sim(nucleo)
            await asyncio.to_thread(nucleo.sim_mj.carregar, caminho)
        elif tipo == "sim_politica_giro":
            caminho = treino.politica(msg["nome"]) if msg.get("nome") else None
            if caminho and not os.path.exists(caminho):
                caminho = await asyncio.to_thread(treino.exportar, msg["nome"])
            await _criar_sim(nucleo)
            await asyncio.to_thread(nucleo.sim_mj.carregar_giro, caminho)
        elif tipo == "sim_config" and nucleo.sim_mj:
            await asyncio.to_thread(nucleo.sim_mj.configurar, msg.get("vx"), msg.get("massa"), msg.get("empurroes"),
                                    msg.get("vy"), msg.get("giro"))
        elif tipo == "sim_reiniciar" and nucleo.sim_mj:
            nucleo.sim_mj.reiniciar()
        elif tipo == "sim_empurrar" and nucleo.sim_mj:
            nucleo.sim_mj.empurrar(float(msg.get("forca", 1.5)))
        elif tipo == "sim_empurrar_ponto" and nucleo.sim_mj:   # clique no robo (modo empurrao)
            nucleo.sim_mj.empurrar_em(str(msg["corpo"]), msg["ponto"], msg["direcao"], float(msg.get("forca", 1.5)),
                                      float(np.clip(msg.get("duracao", 0.1), 0.02, 1.0)))
        elif tipo == "rl_iniciar":
            nome = await asyncio.to_thread(treino.iniciar, msg.get("nome"), msg.get("continuar"),
                                           msg.get("passos"), msg.get("envs"))
            await ws.send_json({"tipo": "aviso", "texto": f"Treino {nome} iniciado."})
        elif tipo == "rl_parar":
            treino.parar()
            await ws.send_json({"tipo": "aviso", "texto": "Parando: o treino salva e encerra em alguns segundos."})
        elif tipo == "rl_config":
            treino.salvar_config(msg["config"])
        elif tipo == "rl_restaurar":
            treino.restaurar_recompensas()
        elif tipo == "rl_python":
            treino.salvar_config({"python": msg.get("python", "")})
            ok = await asyncio.to_thread(treino.verificar_python)
            await ws.send_json({"tipo": "aviso", "texto": f"Python para treino: {ok}" if ok else
                                "Nenhum Python com torch + stable-baselines3 + mujoco encontrado."})
        elif tipo == "rl_exportar":
            await asyncio.to_thread(treino.exportar, msg["nome"])
        if tipo.startswith("rl_") or tipo in ("sim_politica", "sim_politica_giro"):
            await ws.send_json({"tipo": "rl_config", "config": treino.config, "padrao": treino.padrao})
            await nucleo.difundir({"tipo": "rl_lista", "execucoes": await asyncio.to_thread(treino.listar)})
    except Exception as e:
        logging.getLogger("humanoide").exception(tipo)
        await ws.send_json({"tipo": "aviso", "texto": f"{tipo}: {e}"})


OPERACOES_BIBLIOTECA = ("biblioteca", "salvar_pose", "apagar_pose", "salvar_anim", "apagar_anim")


async def tratar_biblioteca(nucleo, ws, msg):
    tipo = msg["tipo"]
    try:
        if tipo != "biblioteca":
            alvo = "poses" if tipo.endswith("pose") else "animacoes"
            if tipo.startswith("salvar"):
                await asyncio.to_thread(biblioteca.salvar, alvo, msg["nome"], msg["valor"])
            else:
                await asyncio.to_thread(biblioteca.apagar, alvo, msg["nome"])
        dados = await asyncio.to_thread(biblioteca.carregar)
        await (ws.send_json if tipo == "biblioteca" else nucleo.difundir)({"tipo": "biblioteca", **dados})
    except Exception as e:
        await ws.send_json({"tipo": "aviso", "texto": f"{tipo}: {e}"})


def criar_app(nucleo, porta_serial=None):
    async def ws_handler(request):
        ws = web.WebSocketResponse()
        await ws.prepare(request)
        nucleo.clientes.add(ws)
        await ws.send_json(nucleo.info())
        if nucleo.hw:
            await ws.send_json({"tipo": "hw_config", "config": nucleo.hw.config})
        await ws.send_json({"tipo": "eq_config", "config": nucleo.equilibrio.cfg})
        if nucleo.treino:
            await ws.send_json({"tipo": "rl_config", "config": nucleo.treino.config, "padrao": nucleo.treino.padrao})
            await ws.send_json({"tipo": "rl_lista", "execucoes": await asyncio.to_thread(nucleo.treino.listar)})
        async for m in ws:
            if m.type != WSMsgType.TEXT:
                continue
            msg = json.loads(m.data)
            if msg["tipo"].startswith("hw_"):
                asyncio.create_task(tratar_hw(nucleo, ws, msg))
            elif msg["tipo"] == "controlador":
                nucleo.trocar(msg["nome"])
                await nucleo.difundir(nucleo.info())
            elif msg["tipo"].startswith(("sim_", "rl_")):
                asyncio.create_task(tratar_rl(nucleo, ws, msg))
            elif msg["tipo"].startswith("eq_"):
                asyncio.create_task(tratar_equilibrio(nucleo, ws, msg))
            elif msg["tipo"] in OPERACOES_BIBLIOTECA:
                await tratar_biblioteca(nucleo, ws, msg)
            else:
                # sliders/poses assumem o controle manual; anim_* liga o tocador de animacao
                destino = "animacao" if msg["tipo"].startswith("anim_") else None
                if msg["tipo"] in ("alvo", "pose") and nucleo.ctrl.nome in ("animacao", "agachamento", "acenar"):
                    destino = "manual"
                if destino and nucleo.ctrl.nome != destino:
                    nucleo.trocar(destino)
                    await nucleo.difundir(nucleo.info())
                nucleo.ctrl.comando(msg)
        nucleo.clientes.discard(ws)
        return ws

    async def iniciar(app):
        if porta_serial:
            await nucleo.hw_conectar(porta_serial)
        app["laco"] = asyncio.create_task(nucleo.laco())
        app["status"] = asyncio.create_task(nucleo.laco_status())
        for tarefa in (app["laco"], app["status"]):   # se um laco morrer, o motivo vai para o log
            tarefa.add_done_callback(lambda t: t.cancelled() or not t.exception() or logging.getLogger(
                "humanoide").error("laco parou", exc_info=t.exception()))

    async def parar(app):
        app["laco"].cancel()
        app["status"].cancel()
        await nucleo.hw_desconectar()

    async def baixar_politica(request):
        nome = request.match_info["nome"]
        try:
            dados = await asyncio.to_thread(nucleo.treino.pacote, nome)
        except RuntimeError as e:
            raise web.HTTPNotFound(text=str(e))
        return web.Response(body=dados, content_type="application/zip",
                            headers={"Content-Disposition": f'attachment; filename="{nome}.zip"'})

    async def receber_politica(request):
        form = await request.post()
        arq = form.get("arquivo")
        if not isinstance(arq, web.FileField):
            return web.json_response({"erro": "nenhum arquivo"}, status=400)
        try:
            nome, com_config = await asyncio.to_thread(nucleo.treino.importar, arq.filename, arq.file.read(),
                                                       form.get("nome") or None)
        except (RuntimeError, ValueError) as e:
            return web.json_response({"erro": str(e)}, status=400)
        await nucleo.difundir({"tipo": "rl_lista", "execucoes": await asyncio.to_thread(nucleo.treino.listar)})
        return web.json_response({"nome": nome, "config": com_config})

    app = web.Application(client_max_size=60 * 1024 ** 2)
    app.router.add_get("/ws", ws_handler)
    if nucleo.treino:   # aba Politicas: levar/trazer politicas treinadas entre PCs
        app.router.add_get("/politicas/{nome}.zip", baixar_politica)
        app.router.add_post("/politicas/importar", receber_politica)
    app.router.add_get("/", lambda r: web.HTTPFound("/visualizador/index.html"))
    app.router.add_get("/visualizador/", lambda r: web.HTTPFound("/visualizador/index.html"))
    for pasta in ("visualizador", "modelo", "config"):
        app.router.add_static(f"/{pasta}", f"{RAIZ}/{pasta}")
    if nucleo.treino:   # videos das execucoes de treino (botao "video" da aba de treino)
        from .rl_servico import EXECUCOES
        os.makedirs(EXECUCOES, exist_ok=True)
        app.router.add_static("/execucoes", EXECUCOES)
    app.on_startup.append(iniciar)
    app.on_cleanup.append(parar)
    return app


def main():
    ap = argparse.ArgumentParser()
    ap.add_argument("--porta-http", type=int, default=8790)
    ap.add_argument("--serial", help="porta da ESP32 (ex.: COM5, ou SIMULADO); tambem da para conectar pela pagina")
    args = ap.parse_args()
    print(f"Visualizador: http://127.0.0.1:{args.porta_http}", flush=True)
    web.run_app(criar_app(Nucleo(Robo()), args.serial), host="127.0.0.1", port=args.porta_http, print=None)


if __name__ == "__main__":
    main()
