PedroHiago378/humanoide-12dof/(commit log)

2026-10-30 Humanoide 12 DOF: visualizador 3D, controle e firmware ESP32
    - Conversor STEP -> malhas por elo, robo.json e URDF
    - Visualizador three.js com poses, animacao por keyframe e configuracao dos servos
    - Dinamica (RNEA/CRBA), simulador com modelo do MG90S e controladores
    - Equilibrio pela IMU (MPU-6050) com eixos e juntas configuraveis
    - Firmware ESP32 + PCA9685 (USB e Bluetooth SPP) com mapa de juntas e limites na NVS
    - Programa desktop (PyInstaller)
    [antebraco_L.stl, antebraco_R.stl, braco_L.stl, braco_R.stl, canela_L.stl, canela_R.stl, coxa_L.stl, coxa_R.stl]
2026-11-02 Simulacao MuJoCo e treino por RL dentro do programa
    - rl/: modelo MJCF, ambiente Gymnasium (equilibrio independente do peso,
    movimento fluido, comando omni), treino PPO, exportacao para numpy,
    avaliacao e videos; configs v2, v3, v4/v4b (omni) e giro
    - controle/sim_mujoco.py: simulacao no programa com politica de caminhada
    e politica de giro separada, trocadas conforme o comando
    - controle/rl_servico.py, politica_rl.py: treino em Python externo e
    politicas .npz sem PyTorch
    - visualizador: aba Simulacao e treino (WASD/QE, execucoes, videos)
    - servidor: erro na simulacao nao derruba mais o laco; erros vao para o log
    [antebraco_L.stl, antebraco_L_0.stl, antebraco_R.stl, antebraco_R_0.stl, braco_L.stl, braco_L_0.stl, braco_R.stl, braco_R_0.stl]
2026-11-02 Poses e animacoes no robo livre do MuJoCo, com fisica
    - aba Simulacao: seletor "quem move" (politica de RL ou poses e animacoes
    da aba Controle); no modo poses o controlador do programa da os alvos
    das juntas e o MuJoCo aplica a fisica (pode se equilibrar ou cair)
    - o controle manual parte da pose atual do robo livre e ressincroniza a
    cada reinicio, sem pulo ao trocar politica -> poses
    - modo poses reinicia sem o ruido do treino (parado, ele derrubava o robo)
    - corrige corrida: o ambiente novo so substitui o antigo depois do reset
    (o laco chamava passo() num ambiente ainda nao reiniciado)
    [servidor.py, sim_mujoco.py]
2026-11-02 Aba Simulacao acompanha o servidor e lembra a ultima politica
    A aba mostra a simulacao ligada e as politicas que o servidor esta rodando,
    mesmo quando outra janela as carregou, e a escolha fica salva no navegador.
2026-11-02 Aba Politicas: exportar e receber politicas treinadas
    - exportar: .zip com politica.npz, config.json (ambiente do treino) e info.json
    (GET /politicas/<nome>.zip)
    - receber: .zip exportado ou politica.npz solto, por arraste ou escolha de
    arquivo (POST /politicas/importar); confere se e uma politica deste robo
    (entrada 45/47, saida 12), sem pickle, nome de pasta saneado, sem
    sobrescrever execucoes existentes
    - execucoes so com politica.npz (importadas) aparecem nas listas
2026-11-02 Empurrao com o mouse na simulacao MuJoCo
    Com "empurrar com o mouse" marcado, clicar numa peca do robo aplica uma
    forca naquele ponto do elo, na direcao horizontal em que a camera olha
    (0,1 s; slider de forca, Shift dobra). Arrastar continua girando a camera.
    A forca vai por qfrc_applied (mj_applyFT), com o ponto preso ao elo, e nao
    conflita com os empurroes automaticos do ambiente.
